ayumu-bekki/vhf-am-tx/README.md

# vhf-am-tx

Seeed Studio XIAO ESP32C6 を用いた 144MHz帯 終段ドレイン変調 AM(A1A / A2A / A3E)送信機プロジェクト。
ARDF(アマチュア無線方向探知)用のフォックスハンティング送信機(A2A)、手動キーのCW送信機(A1A)、および音声AM送信機(A3E)として動作します。

## 主な仕様

- **送信周波数**: 144.000 〜 146.000 MHz(20 kHz ステップ、Si5351A PLL制御)
- **電波型式**:
  - **A1A**: 搬送波断続の電信(CWモード専用)
  - **A2A**: トーン変調電信(700 Hz 正弦波、ARDF 5分サイクル・MOE/MOI/MOS/MOH/MO5・MO/S連続送信対応)
  - **A3E**: 振幅変調電話(マイク入力・デジタル音声信号処理 300 Hz〜3 kHz)
- **送信出力**: 搬送波 1.5 W / 変調ピーク 6.0 W(終段 LDMOS `HTL7G06S006P`)。1.5 W / 500 mW / 100 mW の3段から選択可能
- **変調方式**: 終段ドレイン変調(高レベル変調：250 kHz PWM + 2段RCフィルタ + `NJM2125F` / `2SK4017` シリーズパスレギュレータ)
- **電源電圧**: DC 12.8 V(4S LiFePO4 バッテリー、10.5〜17 V 対応、低電圧警告・送信禁止保護機能付き)
- **ユーザーインターフェース**: I2C キャラクタ LCD(`AQM1602Y` / ST7032)+ 3ボタン操作(Mode / Fn+ / Fn-)

## 動作モード

`Mode` ボタンで次の順に切り替わります(Fn+ = SW1、Fn- = SW2)。

| モード | 内容 |
|---|---|
| VOICE | A3E 音声。Fn+ を押している間だけ送信 |
| CW | A1A 手動キー。Fn+ を押している間だけ送信 |
| ARDF | A2A 自動送信。Fn+ で開始、**Fn+ の1秒長押しで停止** |
| FREQ | 周波数(20 kHz ステップ) |
| PWR | 出力切り替え(H:1.5 W / M:500mW / L:100mW) |
| CALL | コールサイン編集 |
| ID | ARDF 識別信号(MOE / MOI / MOS / MOH / MO5 / MO) |
| WPM | CW 速度(5〜40) |

- LCD 上段の右端に出力の段を `H`(1.5 W)/ `M`(500 mW)/ `L`(100 mW)で、VOICE・CW・ARDF モードのときだけ常時表示します(FAULT 表示中は出しません。PWR モードは上段が `H:1.5W` / `M:500mW` / `L:100mW`)。下段の右端はバッテリー電圧です。
- `idf.py menuconfig` の `AM Transmitter` メニューで **ARDF モード**と **CW モード**を個別に無効にできます。ARDF を無効にすると ARDF・ID・WPM の各モードが巡回から外れます(CALL は残ります)。デバッグ用のテストモード(`D:DUTY` / `D:CARR` / `D:TONE` / `D:DOT` / `D:BRST`)も同じメニューで有効にします。`D:DOT` は A1A の短点を連続送出し、`D:CARR` の S は PWR で選んだ段の搬送波を出します。

## ディレクトリ構成

```text
.
├── app/vhf-am-tx/    # ESP-IDF ファームウェア(ESP32-C6 / C++)
│   ├── main/         # アプリケーション本体ソースコード
│   └── test/         # ホストPC上で実行可能な単体テスト
├── pcb/vhf-am-tx/    # KiCad 基板設計データ(100×100mm 2層基板)およびガーバーデータ
└── doc/              # ハードウェア設計書(回路・定数・部品表・立ち上げ調整記録)
```

## ビルドとテスト

### ファームウェアのビルド・書き込み

本ファームウェアは **ESP-IDF**(ターゲット: `esp32c6`)を使用します。

```sh
cd app/vhf-am-tx
idf.py set-target esp32c6
idf.py build
idf.py flash monitor
```

> **Note**: 実機で USB ケーブルを接続して書き込みを行う際は、基板上のジャンパ `J12`(BP5293-33 3.3V出力 ↔ XIAO 3V3)を取り外し、電源の競合を避けてください。また、ベンチテスト時やデバッグモードを有効化する場合は `idf.py menuconfig` の `AM Transmitter` メニューから設定を変更できます。

### ホスト単体テストの実行

CWキーヤ(A1A の波形と CLK0 切り替えのタイミングを含む)・ARDFスケジューラ・出力の段のデューティ写像・送信シーケンス(ドレイン電圧ランプダウン後のキャリア遮断順序など)のロジックは、実機なしでホストPC上で高速にテストできます。

```sh
cd app/vhf-am-tx/test
./run_tests.sh
```

## ドキュメント

ハードウェアの詳細設計、回路定数の根拠、コイルの巻き方、部品表(BOM)、および立ち上げ・調整手順については以下を参照してください。

| 資料 | 内容 |
|---|---|
| [回路設計書](docs/01-circuit-design.md) | 回路と定数の根拠、電源、レベル配分、設計上の注意、付録A マイク入力 |
| [製作ガイド](docs/02-build-guide.md) | 部品表、基板 v0.1、2SK4017 の取り付けとケース、手巻きコイル |
| [調整手順書](docs/03-bring-up.md) | 切り離し点と測定点、測定器と測り方、立ち上げ手順 1〜9、試作で決まった値、実測記録 |
| [ホスト単体テスト](app/vhf-am-tx/test/README.md) | |

| 項目 | 値 |
|---|---|
| 周波数 | 144 MHz 帯（Si5351A） |
| 電波型式 | A1A / A2A / A3E |
| 最大出力 | 搬送波 1.5 W（ピーク 6 W）|
| 変調 | 終段ドレイン変調（NJM2125F ＋ 2SK4017 のシリーズパス） |
| 終段 / ドライバ | HTL7G06S006P（C級）/ 2SC4703（A級） |
| MCU | Seeed XIAO ESP32-C6 |
| 電源 | 4S LiFePO4（12.8 V） |

## ライセンス

本プロジェクトは [CERN Open Hardware Licence Version 2 - Permissive (CERN-OHL-P v2)](LICENSE) のもとで公開されています。
