ayumu-bekki/vhf-am-tx/docs/02-build-guide.md

# 144MHz 送信機 製作ガイド

v0.1 基板（1枚・100×100mm・2層）を**組み立てるとき**に開く資料。部品表、基板の要点、2SK4017 の取り付けとケース、手巻きコイルを扱う。回路の理由は [回路設計書](01-circuit-design.md)、立ち上げと調整は [調整手順書](03-bring-up.md)。

| 項目 | 値 | 補足 |
|---|---|---|
| Frequency | **144 MHz** | Si5351A / PLL |
| Emission | **A2A** | トーン変調電信 |
| Power | **1.5 W** | 搬送波 / ピーク 6 W |
| Modulation | **Drain** | 終段ドレイン変調 |
| Battery | **12.8 V** | 4S LiFePO4 / 約 0.7 A |

**目次**

- [01 部品表](#01-部品表)
- [02 基板（v0.1）](#02-基板v01)
- [03 2SK4017 の取り付けとケース](#03-2sk4017-の取り付けとケース)
- [04 手巻きコイルの製作](#04-手巻きコイルの製作)

## 01 部品表

回路図 `AmTransmitter.kicad_sch`の記号に対応させた一覧。全体を1枚の基板（100×100mm・2層）に載せる。基板に載らないのは BT1、SW1〜SW3、Q2（2SK4017）と、その足元に付ける R9・C5・J7。コイルの巻き方は 04章、判断の根拠は別資料の設計判断記録を参照。

コネクタとテストポイント：

- **電源** — J5 = バッテリー（XT30）、J4 = 主電源スイッチ SW_Power（XH 2ピン）、J8 = NJW4190M。
- **ジャンパ** — J11 = ドライバのコレクタ給電（+8V）、J12 = BP5293-33 → XIAO 3V3（USB 書き込み時は外す）、J13 = 終段のドレイン給電（Mod → L8）。
- **信号** — J1〜J3 = 押しボタン SW1〜SW3、J6 / J7 = 2SK4017 への引き出し（基板側 / FET 側）、J9 = マイク、J10 = LCD、**J14 = RF 出力**。
- **テストポイント** — TP2 = Mod（変調器出力）、TP3 = +8V、TP5 = ゲートバイアス、TP6 = BP5293-33 出力、TP9 = +3.3VB、TP1 / TP4 / TP7 / TP8 = GND（TP4 は R28、TP8 は R37、TP7 は R36 の隣）。

### バッテリーと保護

| 記号 | 定数 / 型番 | 備考 |
|---|---|---|
| BT1 | LiFePO4 4S 12.8V | 3〜6Ah。10.5〜17V が使用可能範囲 |
| F1 | ポリスイッチ 1.85A / 30V | 60°C で保持 1.2A。ピーク 1.05A に対して余裕あり |
| J5 | XT30（基板取付） | バッテリー入力。pin1 = GND、pin2 → F1 |
| J4（SW_Power） | XH 2ピン → 外付け SPST | 主電源。押しボタン（SW1〜SW3）と役割が違うので、スイッチ自体には番号を振らずコネクタ J4 で区別する |
| Q1 | SSM3J334R（Pch） | 逆接保護。D=電池側 / S=負荷側 / G=R6 経由で GND。V<sub>GSS</sub> ±20V（設計判断記録 ADR-015） |
| D1 | 6.8V ツェナー | Q1 の G-S間クランプ。電池電圧（10.5〜17V）が常時 Vgs にかかる構成のため、余裕を持たせる（ADR-015） |
| R6 | 100 kΩ | Q1 のゲート抵抗（G → GND）。D1 が導通したときの電流を約 0.1mA（17V 時）に抑える。省略してゲートを GND に直結しないこと（ADR-015） |
| C4 | 470 µF | 入力バルク。**耐圧 25V 以上**（電池が最大 17V） |
| R4 / R7 | 100 kΩ / 18 kΩ | バッテリー電圧監視の分圧（→ D0）。比 6.556 で 17V→2.59V、10.5V→1.60V。**逆接保護 Q1 の後ろ**から取る。常時 144µA |
| C7 | 0.1 µF | R7 と並列。**省略不可** — マイクと ADC を共用するため、分圧の高インピーダンスが隣の変換に漏れるのを防ぐ |

### 17.4V（変調器オペアンプ用）

| 記号 | 定数 / 型番 | 備考 |
|---|---|---|
| J8 | NJW4190M | 倍電圧チャージポンプ |
| C10 / C9 | 1 µF / 1 µF | 入力 / フライング |
| C18 / C19 | 1 µF / 10 µF | 出力 |
| R16 / R17 | 10 kΩ / 130 kΩ | FB→GND / FB→VOUT。`1.24 × (1+130/10) = 17.4V` |
| R11 / R14 | 33 kΩ / 10 kΩ | +BATT から J8（NJW4190M）の 7番ピンへの分圧（回路図どおり） |

### 8V（変調器パス・ドライバ・ゲートバイアス）

| 記号 | 定数 / 型番 | 備考 |
|---|---|---|
| U4 | RT8250GSP | 降圧 3A |
| C26 / C27 | 10 µF / 10 µF | 入力 |
| C36 | 0.1 µF | SS ピン（ソフトスタート）のバイパス |
| C28 | 0.01 µF | ブートストラップ |
| R24 | 100 kΩ | EN プルアップ |
| C38 / R30 | 4700 pF / 12 kΩ | 位相補償 |
| L5 | 15 µH | 2A 以上の飽和電流 |
| R25 / R27 | 39 kΩ / 5.1 kΩ | FB。`0.923 × (1+39/5.1) = 7.98V` |
| C31 | 22 µF | コンバータ直近。帰還ループはこれで決まる |
| FB1 | BLM18PG121SN1D | 120Ω@100MHz / 2A / 0.05Ω。ドライバと終段の RF がコンバータへ回り込むのを止める |
| C32 / C33 / C34 / C35 | 470 µF / 10 µF / 0.1 µF / 1000 pF | **ビーズの負荷側**。470µF が 700Hz の落ち込みを支える |

### 3.3V(A)（MCU）

| 記号 | 定数 / 型番 | 備考 |
|---|---|---|
| U5 | BP5293-33 | ROHM。3端子内蔵型 DC/DC。コイル・コンデンサ内蔵。7〜26V → 3.3V / 1A、SLLM制御 570kHz |
| C47 | 10 µF セラミック | 入力。データシート推奨値 |
| C49 | 22 µF セラミック | 出力。内蔵コンデンサのみでも動作するが、SLLM動作のリップル（50〜200mVpp）を抑えるため追加 |
| J12 / TP6 | 2ピン（ジャンパ）/ テストポイント | BP5293-33 出力 → XIAO 3V3（+3.3VA）。**USB 書き込み時は外し**、内蔵レギュレータとの競合を避ける（ADR-014）。TP6 は BP5293-33 側 |
| C48 | 100 µF | BLE 送信バーストの吸収 |

### 3.3V(B)（Si5351A 専用）

| 記号 | 定数 / 型番 | 備考 |
|---|---|---|
| R38 | 82 Ω | LDO の損失を 179mW → 65mW に。C62 と組んで fc 194Hz |
| C62 | 10 µF | LDO 入力 |
| U6 | NJM78L33SU3 | 3端子 3.3V |
| C63 | 0.1 µF | LDO 出力 |
| FB2 | BLM18PG121SN1D | **電源を綺麗にするためではなく、145MHz の閉じ込めのため**（[回路設計書 09章](01-circuit-design.md#09-電源系統)）。DCR 0.05Ω なので 38mA で 2mV しか落ちない |
| C64 / C65 | 10 µF / 0.1 µF | **モジュール直近に最短で** |

### MCU とトーン生成（M1 / M2）

| 記号 | 定数 / 型番 | 備考 |
|---|---|---|
| U1 | XIAO-ESP32-C6 | 3V3 ピンから給電。VBUS は未接続 |
| R2 / R3 | 10 kΩ × 2 | I2C プルアップ（SCL / SDA）。<strong>+3.3VA へ</strong>（Si5351A モジュールに内蔵なし。[回路設計書 09章](01-circuit-design.md#09-電源系統)） |
| R21 / C23 | 1 kΩ / 0.047 µF | 1段目 RC |
| R22 / C24 | 1 kΩ / 0.047 µF | 2段目 RC。合成 fc 3.39kHz |
| R23 | 100 kΩ | Tone PWM のプルダウン。Hi-Z の間に変調器の基準を 0V に落とす（[回路設計書 04章](01-circuit-design.md#04-m2-トーン生成と平滑フィルタ)） |
| SW1 / J1 | 押しボタン（D10、ネット SW 0） | モード切替。基板から除外 — 実装時は外部配線かパネル取付 |
| SW2 / J2 | 押しボタン（D9、ネット SW 1） | Function ＋（音声モードでは PTT）。基板から除外 |
| SW3 / J3 | 押しボタン（D8、ネット SW 2） | Function −。基板から除外 |

### 表示

| 記号 | 定数 / 型番 | 備考 |
|---|---|---|
| J10 | AQM0802A-RN-GBW（9ピンコネクタ接続） | ST7032 / 8×2 / I2C（0x3E）。VDD 3.1〜3.5V、消費 0.4mA、バックライトなし。**電源は +3.3VA** |
| C14 / C15 / C16 | 1 µF / 1 µF / 0.1 µF | 内蔵昇圧用とバイパス。データシート指定 |
| （RESET） | 10 kΩ プルアップ または GPIO | 開放にしない |
| （SDA / SCL 直列） | 100 〜 220 Ω | ケーブルで引き出す場合。エッジを鈍らせて RF の回り込みを抑える |

### マイク（回路設計書 付録A）

| 記号 | 定数 / 型番 | 備考 |
|---|---|---|
| J9 | AE-SPU0414（SPU0414HR5H-SB） | 1 = VDD、2 = OUT、4 = GND |
| R10 / C12 | 100 Ω / 10 µF | マイク電源のフィルタ（fc 約 160Hz）。C12 はモジュールの近く |
| C11 | 0.01 µF | 交流結合。バイアス 50kΩ と組んで fc 318Hz のハイパス |
| R12 / R15 | 100 kΩ × 2 | ADC バイアス 1.65V。**R12 の上側は R10 / C12 の接続点から**（+3.3VA 直結にしない） |
| R13 / C13 | 1 kΩ / 0.047 µF | アンチエイリアス（fc 3.4kHz）→ MicADC（D1） |

### 変調器（M3）

| 記号 | 定数 / 型番 | 備考 |
|---|---|---|
| R1 / C1 | 100 Ω / 10 µF | 17.4V の 300kHz リプル除去 |
| U2 | NJM2125F | 単電源・入力同相に GND を含む |
| R5 / R8 | 10 kΩ / 22 kΩ | FB→GND / FB→ソース。1/3.2 分圧（ゲイン 3.2）。20k から変更（ADR-024）— **ファームウェアの定数と対** |
| C6 | 1000 pF | オペアンプ出力 ↔ −入力。位相補償（ADR-026）。ピン直近 |
| C2 / C3 / C25 | 0.1µF＋1000pF / 1000pF | V+ と＋入力。RF の飛び込み対策。ピン直近 |
| R9 | 470 Ω | ゲート直列。**J7 側、ゲートの足に直付け** |
| Q2 | 2SK4017 | ソースフォロワ。TO-220SIS。**ケース側板に取付、外側にヒートシンク**（03章） |
| C5 | 0.1 µF | **J7 側、D–GND**。ドレインの足元のパスコン |
| J6 / J7 | 4ピンコネクタ ×2 | 基板側 / FET 側。1 = +8V・D、2 = オペアンプ出力・R9、3 = GND、4 = Mod・S。4本より合わせ 10cm 以内、電流線は AWG22〜20 |
| （ヒートシンク） | 8°C/W 以下 | ケース外側、2SK4017 の真裏。M3 共締め・グリス2面 |
| C8 | 0.1 µF | ソースフォロワ出力のバイパス。**基板側の Mod / TP2 ノード**。**出力クランプ用ツェナーは不要**（[回路設計書 03章](01-circuit-design.md#03-変調器m3の回路図)。バッテリー逆接保護の D1 とは別の話） |

### 搬送波生成とフィルタ

| 記号 | 定数 / 型番 | 備考 |
|---|---|---|
| U3 | AE-Si5351A-B | 1=VDDO / 2=SCL / 3=SDA / 4=GND / 5=CLK0 / 8=VDD。基準 25MHz |
| C17 | 1000 pF | 直流阻止。**パッドの前** |
| R19 / R18 / R20 | 300 Ω / 18 Ω / 300 Ω | 3dB π型パッド |
| L1 / L2 / L3 | 47 nH × 3 | 定数k LPF。チップ B82498F3470J000（04章） |
| C20 / C21 / C22 | 22 pF × 3 | 同上 |

### ドライバ段

| 記号 | 定数 / 型番 | 備考 |
|---|---|---|
| R28 / TP4 | 0 Ω / GND テストポイント | 段間の切り離し（Si5351A のフィルタ → ドライバ）。外してピグテールを当てる（調整手順書） |
| J11 | 2ピン（ジャンパ） | +8V → ドライバのコレクタ給電（R26・L4・C29 / C30）。外すとドライバだけ止められる |
| C40 | 1000 pF | 直流阻止 |
| C41 | 30 pF トリマ | 入力並列 C（設計値 22pF） |
| L7 | 56 nH | 自作・可変 |
| R29 | 10 Ω | ベース直列。発振時は 22Ω へ |
| R26 / R31 | 3 kΩ / 620 Ω | ベースバイアス。Rth 514Ω |
| Q3 | 2SC4703 | Vcbo 25V。8V で使う |
| R32 / C42 | 12 Ω / 2200 pF | エミッタ。素子直下に最短で。R32 は 22Ω から変更（ADR-025） |
| L4 | 2.2 µH **巻線型** | コレクタ RFC。B82498F1222J000（SRF 330MHz / 130mA / 1.6Ω）。直流 30〜40mA なので定格に余裕あり。**積層チップは不可**（[回路設計書 07章](01-circuit-design.md#07-終段の整合回路)） |
| C29 / C30 | 1000 pF / 0.1 µF | コレクタ給電のバイパス |
| C39 | <strong>実装しない（DNP）</strong> | コレクタ並列 C。浮遊 6.63pF ＋ Cob 1.5pF で必要量 8.5pF がほぼ埋まる（[回路設計書 06章](01-circuit-design.md#06-ドライバ段2sc4703)・ADR-020）。パッドは残す — 抵抗置換法で Cob の代役を仮付けする場所になる |
| L6 | 120 nH | 自作・可変 |
| C37 | 1000 pF | 直流阻止。**直流が乗っている側に置く** |

### 終段：ゲートバイアスと入力整合

| 記号 | 定数 / 型番 | 備考 |
|---|---|---|
| R33 / RV1 | 15 kΩ / 10 kΩ 半固定 | 0〜3.20V。多回転型。3端子結線 |
| C44 / C45 / C46 | 10 µF / 0.1 µF / 1000 pF | 700Hz 除去 / 中域 / RF 接地 |
| R34 | 220 kΩ | ブリーダ。ワイパ断線時に 0V へ |
| R35 / L9 | 100 Ω / 1 µH **巻線型** | B82498F1102J000。ゲートは直流を流さないので**定格電流は不問**（RF 1mA）。**積層チップは不可**（[回路設計書 07章](01-circuit-design.md#07-終段の整合回路)） |
| R37 / TP8 | 0 Ω / GND テストポイント | 段間の切り離し（ドライバ → 終段）。外してピグテールを当てる（調整手順書） |
| TP5 | テストポイント | ゲートバイアス（RV1 のワイパ側） |
| C60 | 15 pF | C61 と並列。C0G 50V。可動域の下駄を履かせるための固定分（ADR-019） |
| C61 | 30 pF トリマ | 入力並列 C。C60 と合わせて **約 20〜45pF**、設計値 33pF（ADR-019） |
| L14 | 33 nH | 自作・可変。**φ3mm に 4回**（ADR-018）。値はデータシート実測 Zs による（ADR-016） |
| C51 | 1000 pF | 直流阻止 |

### 終段：ドレインと出力整合

| 記号 | 定数 / 型番 | 備考 |
|---|---|---|
| Q4 | HTL7G06S006P | LDMOS。ソースのビアを最優先 |
| J13 | 2ピン（ジャンパ） | ドレイン給電（pin1 = Mod、pin2 → C43 → L8）。運用時は短絡。Idq はここに電流計を直列に入れて読む。調整中は 10A レンジの電流計を挟んでドレイン電流を読む（調整手順書） |
| TP3 | テストポイント | +8V。ゲートバイアス分圧（R33 / RV1、0.32mA）も +8V から直接取る |
| C43 | 0.01 µF | **L8 の変調器側**。ドレイン側に付けると出力が出ない |
| L8 | 0.47 µH 空芯（自作） | 145MHz で 471Ω。φ5mm に 14回 |
| L10 | 14 nH | 自作・可変。φ3mm に 2回 |
| C50 | 0.01 µF | 直流阻止 |
| C52 / C53 | **56 pF** / 30 pF トリマ | 出力並列 C。浮遊込みの合計で約 83pF に合わせる（[回路設計書 07章](01-circuit-design.md#07-終段の整合回路)・ADR-021）。当初の 47pF ではトリマが最大端に寄った |

### 出力 LPF とアンテナ

| 記号 | 定数 / 型番 | 備考 |
|---|---|---|
| R36 / TP7 | 0 Ω / GND テストポイント | LPF を単体で掃引するための切り離し（[調整手順書の手順 7](03-bring-up.md#手順-7--終段と-lpfj13-は開けたまま始める)）。**外したまま送信しない** |
| L11 / L13 | 71 nH × 2 | 7次チェビシェフ 0.1dB / fc 160MHz |
| L12 | 78 nH | 中央 |
| C54〜C59 | 22 pF × 6 | 両端 22pF、中間は 22pF×2 で 44pF。**C0G(NP0) 100V**。1608 / 3216 のどちらでも可（基板の footprint に合わせる） |
| J14 | RF 出力（RG-174 直付け） | フットプリント `Coax_RG174_SolderDirect`（1 = 芯線、2 = 網線、網線パッドにビア）。網線はピッグテールにせず広く付け、ケーブルは基板に固定する。調整中はダミーロードへ |

### 発注時に効く指定

値だけで選ぶと失敗する部品をまとめた。**ここに挙がっていない部品は、値と一般的な耐圧（RF 系は C0G 50V、電源系は電圧の2倍）で選んでよい**。

サイズは**メトリック表記**で統一してある — `1608` = 1.6×0.8mm（インチ 0603）、`2012` = 2.0×1.25mm（インチ 0805）、`3216` = 3.2×1.6mm（インチ 1206）。部品によっては型番やシリーズ名にインチ表記が入っている（TDK SIMID 0805-F など）ので、発注時は実寸で確認すること。

| 部品 | 指定 | 理由 |
|---|---|---|
| C54〜C59 | C0G(NP0) **100V** | LPF 中央のノードに 33Vp・0.9Arms がかかる。50V 品では余裕がない。サイズは 1608 / 3216 のどちらでも電気的に成立する |
| C52 / C53 | C0G **100V**（トリマも 100V 級） | ここは LPF 入口と同じ 50Ω 点なので、変調ピークで **24.5Vpk**。C52 には約 0.8Arms も流れる |
| C50 | C0G 50V / **3216**（2012 まで可） | かかる電圧は 1.3V 前後なので耐圧は不問。効くのは電流で、L10 と直列なので **基板上で最大の 1.31Arms** が流れる。ESR の発熱（`I²×ESR`）がパッケージの放熱能力を超えるので **1608 以下にしない**。なお C0G の 0.01µF は体積を食うので、実際には 2012 / 3216 しか選択肢がない |
| C42 | **1608** C0G 2200pF | 自己共振 138MHz を利用して 144MHz でほぼ 0Ω にしている。サイズが変わると共振点が動く |
| RF 系のコンデンサ全般 | **C0G(NP0) 必須** | X7R は損失と電圧係数で使えない（[回路設計書 08章](01-circuit-design.md#08-出力-lpf-の設計)） |
| C41 / C53 / C61 | VHF 用セラミックトリマ | Q が低いとそのまま損失になる。C53 は上記のとおり 100V 級。**トリマは 0pF から始まらない**ので、可動域は最小容量込みで見積もる（C39 はこれが原因で DNP になった） |
| L1〜L3 / L4 / L9 | **2012** の巻線（ワイヤワウンド）型 | 積層型は 145MHz では共振点のはるか上で、抵抗として振る舞う（[回路設計書 07章](01-circuit-design.md#07-終段の整合回路)） |
| L5（RT8250） | **飽和電流 2A 以上** | 8V レールのピークが 1.47A |
| C4 / C1 / C9 / C10 / C18 / C19 / C26 / C27 / C47 | 耐圧 **25V 以上** | 電池電圧（最大 17V）とチャージポンプ出力 17.4V が直接かかる |
| C26 / C27 / C47（セラミック） | DC バイアス特性に注意 | 25V 品に 17V を加えると実効容量が半分以下になることがある。35V 品か1サイズ大きいパッケージを選ぶ |
| C32（470µF） | **低 ESR** | 700Hz・0〜1.5A の負荷変動を支える。汎用電解だと変調ピークで 8V レールが落ちる（[回路設計書 09章](01-circuit-design.md#09-電源系統)） |
| C9 / C10 / C18（NJW4190M） | 低 ESR | チャージポンプのフライング／入出力。データシート指定 |
| F1 | 保持電流 1.85A 級 | 60°C では定格の 65〜70% しか流せない。1.0A / 1.35A 品は変調ピークで誤動作する |
| RV1 | 10kΩ <strong>多回転（25回転）</strong>半固定 | Vgs(th) を 0.1V 単位で追い込むため。3端子（ポテンショメータ）結線で使う |
| 検波プローブのダイオード | 1SS270A（DC 60V） | 逆電圧が 49V に達する。1SS106 / BAT43（ともに 30V）では足りない |

## 02 基板（v0.1）

電源・MCU・変調器・RF 部をすべて1枚に載せる。回路の理由は回路設計書、立ち上げは調整手順書。

### 基板（v0.1）

電源・MCU・変調器・RF 部をすべて <strong>1枚の基板（100×100mm・2層）</strong>に載せる。部品は裏面、表面はほぼ全面 GND ベタ。

- <strong>RF の配線は裏面のマイクロストリップ、基準面は表面の GND ベタ。</strong>表面に配線を通すときは RF の通り道の上を避け、両側に GND ビアを並べる。
- <strong>GND ビアを密に打つ。</strong>RF のシャント C・エミッタのバイパス・Q4 のタブの GND パッドは真横にビア、基板の縁と RF 部の周りは 5mm 間隔程度。RF のシャント C の GND パッドはベタ接続（サーマルリリーフにしない）。
- **インピーダンスの低いノード（50Ω 系・ゲート・ドレイン）は太く短く**（1mm 前後）。高いノード（ドライバのコレクタ、約 280Ω）は細いままでよい — 容量を増やさない。
- **段間は 0Ω（R28 / R37 / R36）で切り離せるようにし、隣に GND のテストポイント**（TP4 / TP8 / TP7）を置く。NanoVNA のピグテールはここに当てる（調整手順書）。
- <strong>変調器（U2・J6）は RF 出力 J14 から離す。</strong>オペアンプの入力は RF が入ると整流されて出力がずれる。ピン直近のパスコン（C2 / C3 / C25）と、Mod・+8V の基板側の 1000pF（C66 / C67）で守る。
- <strong>RF 出力 J14 は RG-174 の直付け。</strong>網線はピッグテールにせず、網線パッドに広く付ける。ケーブルは基板に固定する。

### 実装の注意

- <strong>SOT-89 の放熱。</strong>終段の損失は搬送波時で約 0.7W（試作で電源電流から換算。設計時の見込みは 1.5W）と、通常運用では小さい。それでも異常時に跳ね上がるので経路は省かない。SOT-89 は熱抵抗が高いので、タブ下にベタ銅箔＋サーマルビアは必須です（v0.1 基板はタブ下とその周りに格子状のビア）。ここを軽く見ると変調ピークで素子温度が限界を超えます。**目標は 10°C/W 以下** — 変調基準が 3.3V に張り付いて 8V 連続になっても損失 6.3W / 温度上昇 63°C で収まり、素子を失わずに済みます（[回路設計書 03章](01-circuit-design.md#03-変調器m3の回路図)）。
- <strong>8V ラインにフェライトビーズ + 0.1µF。</strong>降圧DC-DC のインダクタは RF 部から離します。

## 03 2SK4017 の取り付けとケース

変調器のパス素子 2SK4017 は基板に載せず、ケースの側板に取り付けてリード線で基板とつなぐ。

### 2SK4017 の引き出し

**ケースの側板に取り付けてリード線で基板とつなぐ**。基板側 **J6** と FET 側 **J7**（どちらも 4ピン）の間を、4本より合わせた線で結ぶ。

| ピン | 基板側 J6 | FET 側 J7 | 線 |
|---|---|---|---|
| 1 | +8V | D（C5 の片側） | AWG22〜20。最大 1.5A |
| 2 | オペアンプ出力 | R9 470Ω → G | 細線で可 |
| 3 | GND | C5 の GND 側 | 細線で可 |
| 4 | Mod（C8・R8・TP2） | S | AWG22〜20。最大 1.5A |

> [!WARNING]
> **ソースフォロワを配線で伸ばすときの約束**
>
> - <strong>R9（470Ω）はゲートの足に直付け。</strong>基板側に残して長い線でゲートへ行くと、線のインダクタンスとゲート容量で VHF の寄生発振を起こしやすい。
> - <strong>C5（0.1µF）を FET の足元で D–GND。</strong>GND はケースではなく J7 の pin3（4本目の線）に取る。アルマイトの側板は本体と導通していないことがある。
> - <strong>帰還（R8）と C8 は基板側の Mod ノード。</strong>線の抵抗による電圧降下（1.5A で数十 mV）もループが補正する。線のインダクタンスはループに入るが、高域は C6 でオペアンプ出力から帰還しているので影響は小さい。
> - <strong>4本をより合わせて 10cm 以内（できれば 5cm）。</strong>RF 基板とアンテナコネクタの近くを通さない。
> - 基板側 J6 の pin3 は R5 やオペアンプの GND ではなく **8V 電源側の GND** に寄せる。J6 は 8V レールの出力コンデンサの近くに置く。

### 2SK4017 の取り付け

損失は最大約 3W（3.5W で設計）、放熱器側に許される熱抵抗は 12°C/W 以下（[回路設計書 03章](01-circuit-design.md#03-変調器m3の回路図)「放熱の見積もり」）。

- <strong>取り付け。</strong>ケース側板（1mm）の内側に 2SK4017、**同じ位置の外側にヒートシンク**を当て、M3 ネジ1本で3枚を共締めする。グリスは2面とも。板厚方向の熱抵抗は 0.05°C/W 程度で無視でき、1mm 板で熱が横に広がらない問題はヒートシンクが受け持つ。**ヒートシンクはカタログ値 8°C/W 以下**（40×40mm・フィン高 20mm 前後が目安）、フィンは縦向き。放熱用両面テープは使わない。
- <strong>絶縁は不要。</strong>TO-220SIS（フルモールド）なのでネジもヒートシンクも GND 電位でよい。
- <strong>確認。</strong>連続 30分で、ヒートシンクの根元（素子の真裏）が **60°C 以下**なら合格（チャネルはおよそ +25°C 以内）。

### ケースと GND

- <strong>ケースはアルミにして GND につなぐ。</strong>シールド（アンテナから戻る RF を変調器・MCU に入れない、終段の高調波を外へ漏らさない）と、2SK4017 の放熱を兼ねる。
- <strong>主な接地点は RF 出力のパネルコネクタ。</strong>RG-174 の反対側をパネル取付の BNC / SMA につなぎ、そのフランジでケースに落とす。
- <strong>基板は四隅の取付穴（H1〜H4、GND）から金属スペーサでケースに落とす。</strong>高周波では短く多点でつなぐほうが効く。
- <strong>大電流の戻りはケースに流さない。</strong>ドレイン電流（最大 1.5A）と電源の戻りは配線と基板の GND で返す。ケースは同じ電位にそろえるだけ。
- <strong>アルマイトや塗装は絶縁体。</strong>接触部は削るか菊座金で食い込ませる。**フタと側板も本体と導通させる**（浮いたままだとシールドが大きく落ちる）。
- <strong>ケーブルは固定する。</strong>RG-174 と 2SK4017 への4本の線は、はんだ部分に力がかからないよう基板やケースに固定する。

## 04 手巻きコイルの製作

手巻きにする 8本はすべて空芯で自作する。**φ0.65mm ポリウレタン線（2UEW、外径 0.694mm）を φ5mm（L10 / L14 は φ3mm）の丸棒に巻く**前提で定数を出した。平均直径は `心棒径 + 0.65mm`。巻数と巻き長はホイーラーの式による。チップで代用するコイル（L1〜L3、L4、L9）はここには含めない。使い分けの判断は次項を参照。

| 記号 | 用途 | 心棒 | 目標 | 巻数 | 巻き長 | ピッチ | 密着巻き時 |
|---|---|---|---|---|---|---|---|
| L8 | 終段ドレイン給電 | φ5 mm | 0.47 µH | 14 T | 10.6 mm | 0.75 mm | 0.50 µH |
| L6 | ドライバ出力整合（可変） | φ5 mm | 120 nH | 6 T | 6.9 mm | 1.15 mm | 169 nH |
| L12 | 出力 LPF 中央 | φ5 mm | 78 nH | 4 T | 3.9 mm | 0.98 mm | 95 nH |
| L11 / L13 | 出力 LPF 両端 | φ5 mm | 71 nH | 4 T | 4.5 mm | 1.13 mm | 95 nH |
| L7 | ドライバ入力整合（可変） | φ5 mm | 56 nH | 4 T | 6.4 mm | 1.61 mm | 95 nH |
| L14 | 終段入力整合（可変） | **φ3 mm** | 33 nH | 4 T | 4.7 mm | 1.18 mm | 48 nH |
| L10 | 終段出力整合（可変） | **φ3 mm** | 14 nH | 2 T | 2.1 mm | 1.05 mm | 17 nH |

手巻きにするのは 8本で、必要な線材は総延長で約 87cm（リード分込み）。10m 巻きを1本買えば足りる。心棒は **L10 と L14 が φ3mm、残り6本は φ5mm**。丸棒はドリルの軸で代用できる。

可変コイルの目標値は出発点で、最後は実測で決まる。試作で追い込んだ結果は **L6 ≈ 116nH**（設計 120nH）、<strong>L10 ≈ 14.1nH（リード込み）</strong>（設計 14nH）。L10 は見た目がかなり広がった状態で合ったが、リードのインダクタンスが加わっているためで、値としては正しい。L7 / L14 は大信号で決めるので未確定（[調整手順書 04章](03-bring-up.md#04-試作で決まった値調整の出発点)）。

> [!WARNING]
> **小さい値のコイルは心棒を細くする**
>
> - 目標が小さいコイルを φ5mm で作ると、巻数が足りないぶんを**ピッチを広げて稼ぐ**ことになる。線径 0.694mm に対して隙間が線径以上に開くと「ほぼバネ」になり、手で触れただけで形が変わってインダクタンスが動く。
> - <strong>L10（14nH）</strong>は φ5mm だと 2回でピッチ 3.2mm（隙間が線径の 3.6倍）。**φ3mm で 2回・ピッチ 1.05mm** にすると隙間は線径の半分に収まる。
> - <strong>L14（33nH）</strong>も同じ問題で、φ5mm・3回だとピッチ 2.01mm（隙間が線径の 1.9倍、密着巻きの 2.9倍まで引き伸ばすことになる）。**φ3mm・4回・ピッチ 1.18mm** なら隙間は線径の 0.49倍で、引き伸ばし率も 1.7倍に収まる（ADR-018）。
> - 可変コイルは伸縮させて追い込む前提なので、**目標値が可動域の真ん中あたりに来る**のが望ましい。L14 は φ3mm・4回にすることで、目標域 29〜35nH が巻き長 4.35〜5.59mm という扱いやすい幅に対応する。

> [!WARNING]
> **L8 に 1µH は要らない**
>
> - チョークに求められるのは「145MHz でドレインの負荷 3.5Ω に対して十分高いこと」だけ。**0.47µH でも 471Ω = 134倍**あり、負荷への影響は 0.7% にとどまる。
> - 長いソレノイドでは `L = µ₀ N A / p` なので、**巻数は L に比例し、直径の2乗に反比例**する。1µH のままだと φ5mm で 27回・20mm になるが、0.47µH なら **14回・10.6mm** で済む。
> - 線長は 479mm → 248mm、DCR は 24.8mΩ → 12.9mΩ。自己共振も 331MHz → 482MHz と遠ざかる。
> - 心棒を φ10mm にして 1µH のまま 11回にする手もあるが、直径が増えるぶん磁界が広がって出力 LPF と結合しやすい。**φ5mm で統一するほうが実装が楽**。
> - C43（0.01µF）との直列共振は 73MHz。ここには何も存在しないので問題ない。

### チップと手巻きの使い分け

チップは **2012（インチ 0805）の巻線（ワイヤワウンド）型**に限る。積層型は不可（[回路設計書 07章](01-circuit-design.md#07-終段の整合回路)）。判断はコイルに流れる**電流**と、**実測で追い込む必要があるか**の2点で決まる。

| 記号 | 値 | 実装 | 電流（搬送波 / ピーク） | 理由 |
|---|---|---|---|---|
| L1 / L2 / L3 | 47 nH | チップ<br>B82498F3470J000 | 8 mA | SRF 650MHz / 500mA / 0.13Ω、セラミックコア。145MHz で 45Ω |
| L4 | 2.2 µH | チップ<br>B82498F1222J000 | 40 mA（直流） | SRF 330MHz / 130mA / 1.6Ω、フェライトコア。145MHz で 2.48kΩ、負荷 281Ω の 8.8倍 |
| L9 | 1 µH | チップ<br>B82498F1102J000 | 1 mA | SRF 440MHz / 240mA / 0.55Ω、フェライトコア。145MHz で 1.02kΩ |
| L8 | 0.47 µH | 手巻き | <strong>0.80 / 1.50 A（直流）</strong> | 変調電流がそのまま流れる。この電流と SRF 300MHz 以上を両立するチップ品が存在しない。空芯なら飽和も無い |
| L6 | 120 nH | 手巻き | 45 mA | 電流は小さいが、伸縮で追い込めるほうが早い |
| L7 | 56 nH | 手巻き | 8 mA | 2SC4703 の Zin が推定値。**可変が前提** |
| L14 | 33 nH | 手巻き | 224 mA | データシート実測の Zs から決めた値（ADR-016）。心棒は φ3mm・4T（ADR-018）。**可変が前提** |
| L10 | 14 nH | 手巻き | **0.66 / 1.31 A** | 3.5Ω 側の直列素子なので**基板上で最も電流が大きい**。2012 チップ（Q=50）だとピークで 0.44W を消費し、定格も超える。空芯なら 0.12W |
| L11 / L12 / L13 | 71 / 78 / 71 nH | 手巻き | 0.17 / 0.35 A | 挿入損失が `0.22dB（Q=180）→ 0.65dB（Q=60）` に増え、1.5W のうち 200mW を失う |

チップは 5個で、<strong>TDK SIMID 0805-F（B82498F）</strong>で全部そろう。シリーズ名の 0805 はインチ表記で、実寸は 2012（2.0 × 1.25mm）。型番4桁目が `1` ならフェライトコア、`3` ならセラミックコア（低い値ほどセラミック）。

出力 LPF をチップにする選択肢もあるが、代償は挿入損失 0.4dB で、**試作の実測では阻止域を決めていたのはコイル間の結合ではなかった**（[回路設計書 08章](01-circuit-design.md#08-出力-lpf-の設計)）。空芯のままでよい。**L10 は電流の点で空芯以外の選択肢がない**。

> [!WARNING]
> **チョークに磁気シールド品は要らない**
>
> - B82498F は非シールドのドラムコアだが、**L4 / L9 が扱う RF 電流は 1〜3mA しかない**ので、外へ漏らす磁束は問題にならない。
> - 逆に拾う側も心配ない。最も電流の大きい L10（ピーク 1.31A）が L9 に `k = 0.01` という密結合をしたとしても、ゲート節点に現れるのは 1.4mV で、ドライブ 2.7V に対して <strong>−66dB</strong>。終段の利得 12dB を足してもループ利得 −54dB で、発振には遠く及ばない。
> - シールド品は磁性体でモールドする構造なので、**SRF と Q が下がる**。チョークにとって一番大事なのが SRF なので、この用途では不利な取り引きになる。B82498F の SRF 440MHz は非シールドだから得られている。
> - シールドが意味を持ちうるのは**出力 LPF をチップ化する場合**だけ。チップにするならシールド品を選ぶ。

### 巻き方

1. <strong>必ず密着巻きしてから伸ばす。</strong>伸ばすとインダクタンスは減る一方なので、目標より大きい状態から近づける。表の「密着巻き時」が出発点。
2. <strong>心棒から抜くと直径が 0.2〜0.4mm 広がる。</strong>インダクタンスが数% 増えるので、抜いた状態で実測して巻き長を詰める。
3. <strong>両端に 10mm のリードを残す。</strong>被覆はライターで焼いてから磨くか、はんだ槽に浸ける。
4. <strong>固定コイル（L8、L11〜L13）は形を接着で固める。</strong>可変の4本（L6 / L7 / L10 / L14）は追い込みが終わってから固定する。

### 実装上の制約

- <strong>出力 LPF の L11 / L12 / L13 はパッドの並びどおりに実装する。</strong>L12 の footprint だけ 90° 回してあるのは隣と軸を直交させるための意図的なもので、見た目を揃えて同じ向きにしない。間隔は直径の2倍以上。なお試作ではコイルを基板に垂直に立てる実験もしたが 433MHz の減衰はほぼ変わらず、コイル間の結合は支配的な要因ではなかった（[回路設計書 08章](01-circuit-design.md#08-出力-lpf-の設計)・ADR-022）。
- <strong>L8 は LPF から離す。</strong>直径が一番大きいコイルなので、軸を LPF と直交させ、できれば基板の反対側へ寄せる。
- <strong>L8 の直流特性。</strong>DCR 12.9mΩ でピーク 1.5A でも 19mV しか落ちない。空芯なので飽和は原理的に存在しない。自己共振は約 482MHz で 145MHz から十分離れており、実効インピーダンスは 471Ω。負荷 3.5Ω に対して 134倍あり、影響は 0.7%。
- <strong>測定は VHF で。</strong>LC メーターは 100kHz 前後で測るので VHF での実効値とずれる。NanoVNA があれば既知のコンデンサと直列共振させて求めるのが確実。

---

*JL1HMT / 144MHz A2A 送信機 — 製作ガイド（2 / 3）。回路設計書・調整手順書と組で使う。*
