ayumu-bekki/vhf-am-tx/pcb/vhf-am-tx/vhf-am-tx.kicad_pcb

## KiCad design pcb/vhf-am-tx/vhf-am-tx.kicad_pcb (2026-10-17)

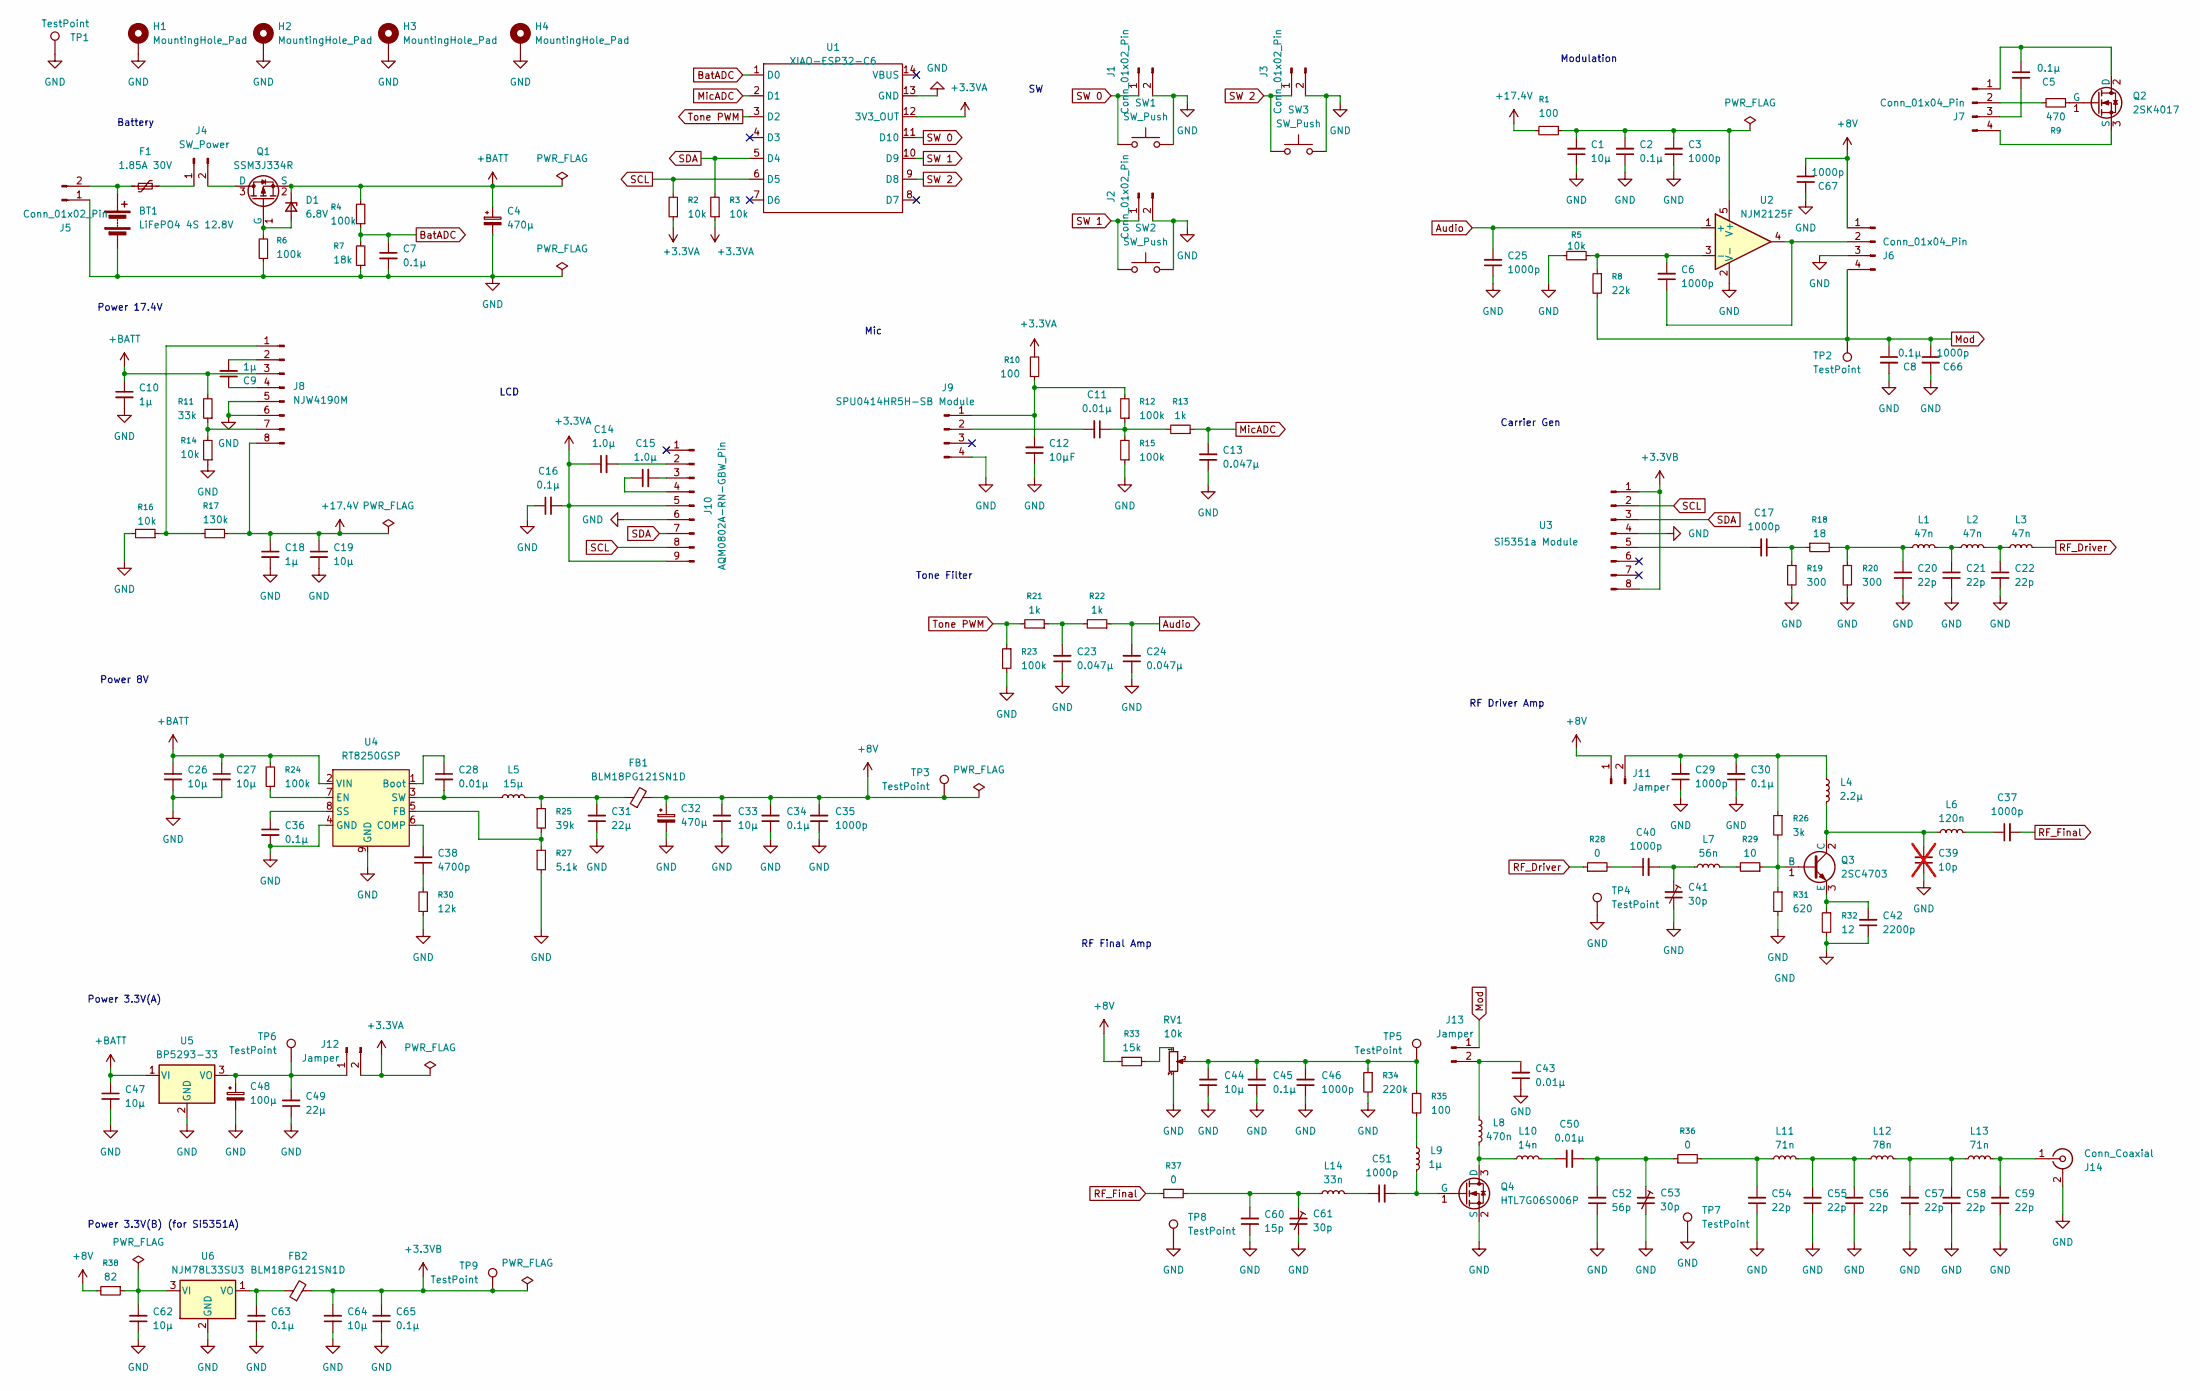
[picture p1: schematic vhf-am-tx.kicad_sch]

Parts:
BT1: LiFePO4 4S 12.8V
C1, C19, C26, C27, C33, C44, C47, C62, C64: 10μ; C_0603_1608Metric_Pad1.08x0.95mm_HandSolder
C2, C5, C7, C8, C16, C30, C34, C36, C45, C63, C65: 0.1μ; C_0603_1608Metric_Pad1.08x0.95mm_HandSolder
C3, C6, C17, C25, C29, C35, C37, C40, C46, C51, C66, C67: 1000p; C_0603_1608Metric_Pad1.08x0.95mm_HandSolder
C4, C32: 470μ; CP_Elec_8x10.5
C9, C10, C18: 1μ; C_0603_1608Metric_Pad1.08x0.95mm_HandSolder
C11, C28, C43: 0.01μ; C_0603_1608Metric_Pad1.08x0.95mm_HandSolder
C12: 10μF; C_0603_1608Metric_Pad1.08x0.95mm_HandSolder
C13, C23, C24: 0.047μ; C_0603_1608Metric_Pad1.08x0.95mm_HandSolder
C14, C15: 1.0μ; C_0603_1608Metric_Pad1.08x0.95mm_HandSolder
C20, C21, C22, C54, C55, C56, C57, C58, C59: 22p; C_0603_1608Metric_Pad1.08x0.95mm_HandSolder
C31, C49: 22μ; C_0603_1608Metric_Pad1.08x0.95mm_HandSolder
C38: 4700p; C_0603_1608Metric_Pad1.08x0.95mm_HandSolder
C39: 10p; C_0603_1608Metric_Pad1.08x0.95mm_HandSolder; not fitted
C41, C53, C61: 30p; C_Trimmer_Murata_TZC3
C42: 2200p; C_0603_1608Metric_Pad1.08x0.95mm_HandSolder
C48: 100μ; CP_Elec_6.3x5.8
C50: 0.01μ; C_1206_3216Metric_Pad1.33x1.80mm_HandSolder
C52: 56p; C_0603_1608Metric_Pad1.08x0.95mm_HandSolder
C60: 15p; C_0603_1608Metric_Pad1.08x0.95mm_HandSolder
D1: 6.8V; D_SOD-323_HandSoldering
F1: 1.85A 30V; Fuse_Bourns_MF-RHT650
FB1, FB2: BLM18PG121SN1D; L_0805_2012Metric_Pad1.05x1.20mm_HandSolder
H1, H2, H3, H4: MountingHole_Pad; MountingHole_3.2mm_M3_Pad
J1, J2, J3: Conn_01x02_Pin; JST_PH_B2B-PH-K_1x02_P2.00mm_Vertical
J4: SW_Power; JST_XH_B2B-XH-A_1x02_P2.50mm_Vertical
J5: Conn_01x02_Pin; AMASS_XT30PW-M_1x02_P2.50mm_Horizontal
J6: Conn_01x04_Pin; PinHeader_1x04_P2.54mm_Vertical
J7: Conn_01x04_Pin
J8: NJW4190M; SOIC-8_5.3x5.3mm_P1.27mm
J9: SPU0414HR5H-SB Module; PinHeader_1x04_P2.54mm_Vertical
J10: AQM0802A-RN-GBW_Pin; PinSocket_1x09_P2.54mm_Vertical
J11, J12, J13: Jamper; PinHeader_1x02_P2.54mm_Vertical
J14: Conn_Coaxial; Coax_RG174_SolderDirect
L1, L2, L3: 47n; L_0805_2012Metric_Pad1.05x1.20mm_HandSolder
L4: 2.2μ; L_0805_2012Metric_Pad1.05x1.20mm_HandSolder
L5: 15μ; L_10.4x10.4_H4.8
L6: 120n; Inductor_HandWound_SMD_Core5.0mm_W10.0mm
L7: 56n; Inductor_HandWound_SMD_Core5.0mm_W10.0mm
L8: 470n; Inductor_HandWound_SMD_Core5.0mm_W10.5mm
L9: 1μ; L_0805_2012Metric_Pad1.05x1.20mm_HandSolder
L10: 14n; Inductor_HandWound_SMD_Core3.0mm_W4.0mm
L11, L13: 71n; Inductor_HandWound_SMD_Core5.0mm_W5.0mm
L12: 78n; Inductor_HandWound_SMD_Core5.0mm_W5.0mm
L14: 33n; Inductor_HandWound_SMD_Core3.0mm_W5.0mm
Q1: SSM3J334R; SOT-23_Handsoldering
Q2: 2SK4017; TO-251-3_Vertical
Q3: 2SC4703; SOT-89-3_Handsoldering
Q4: HTL7G06S006P; SOT-89-3_Handsoldering
R1, R10, R35: 100; R_0603_1608Metric_Pad0.98x0.95mm_HandSolder
R2, R3, R5, R14, R16: 10k; R_0603_1608Metric_Pad0.98x0.95mm_HandSolder
R4, R6, R12, R15, R23, R24: 100k; R_0603_1608Metric_Pad0.98x0.95mm_HandSolder
R7: 18k; R_0603_1608Metric_Pad0.98x0.95mm_HandSolder
R8: 22k; R_0603_1608Metric_Pad0.98x0.95mm_HandSolder
R9: 470; R_0603_1608Metric_Pad0.98x0.95mm_HandSolder
R11: 33k; R_0603_1608Metric_Pad0.98x0.95mm_HandSolder
R13, R21, R22: 1k; R_0603_1608Metric_Pad0.98x0.95mm_HandSolder
R17: 130k; R_0603_1608Metric_Pad0.98x0.95mm_HandSolder
R18: 18; R_0603_1608Metric_Pad0.98x0.95mm_HandSolder
R19, R20: 300; R_0603_1608Metric_Pad0.98x0.95mm_HandSolder
R25: 39k; R_0603_1608Metric_Pad0.98x0.95mm_HandSolder
R26: 3k; R_0603_1608Metric_Pad0.98x0.95mm_HandSolder
R27: 5.1k; R_0603_1608Metric_Pad0.98x0.95mm_HandSolder
R28, R36, R37: 0; R_2512_6332Metric_Pad1.40x3.35mm_HandSolder
R29: 10; R_0603_1608Metric_Pad0.98x0.95mm_HandSolder
R30: 12k; R_0603_1608Metric_Pad0.98x0.95mm_HandSolder
R31: 620; R_0603_1608Metric_Pad0.98x0.95mm_HandSolder
R32: 12; R_0603_1608Metric_Pad0.98x0.95mm_HandSolder
R33: 15k; R_0603_1608Metric_Pad0.98x0.95mm_HandSolder
R34: 220k; R_0603_1608Metric_Pad0.98x0.95mm_HandSolder
R38: 82; R_0603_1608Metric_Pad0.98x0.95mm_HandSolder
RV1: 10k; TSR-3296W
SW1, SW2, SW3: SW_Push
TP1: TestPoint; TestPoint_THTPad_D2.0mm_Drill1.0mm
TP2, TP3, TP4, TP5, TP6, TP7, TP8, TP9: TestPoint; TestPoint_Pad_2.0x2.0mm
U1: XIAO-ESP32-C6; XIAO-ESP32-C6-DIP
U2: NJM2125F; SOT-23-5
U3: Si5351a Module; DIP-8_W7.62mm
U4: RT8250GSP; HSOP-8-1EP_3.9x4.9mm_P1.27mm_EP2.41x3.1mm
U5: BP5293-33; BP5293-XX
U6: NJM78L33SU3; SOT-89-3_Handsoldering

Connections:
+3.3VA: C14.1, C16.2, J10.5, J10.9, J12.2, R2.1, R3.1, R10.2, U1.12 (3V3_OUT)
+3.3VB: C64.2, C65.2, FB2.2, TP9.1 (1_1), U3.1, U3.8
+8V: C32.1, C33.2, C34.2, C35.2, C67.1, FB1.2, J6.1, J11.1, R33.1, R38.2, TP3.1 (1_1)
+17.4V: C18.1, C19.1, J8.8, R1.2, R17.1
+BATT: C4.1, C10.1, C26.1, C27.1, C47.1, D1.1 (K), J8.3, Q1.2 (S), R4.2, R11.2, R24.2, U4.2 (VIN), U5.1 (VI)
Audio: C24.2, C25.2, R22.1, U2.1 (+)
BatADC: C7.1, R4.1, R7.2, U1.1 (D0)
GND: BT1.2 (-), C1.1, C2.1, C3.1, C4.2, C7.2, C8.2, C10.2, C12.1, C13.1, C16.1, C18.2, C19.2, C20.2, C21.2, C22.2, C23.1, C24.1, C25.1, C26.2, C27.2, C29.1, C30.1, C31.1, C32.2, C33.1, C34.1, C35.1, C36.2, C39.1, C41.2, C42.1, C43.1, C44.1, C45.1, C46.1, C47.2, C48.2, C49.1, C52.1, C53.2, C54.1, C55.1, C56.1, C57.1, C58.1, C59.1, C60.1, C61.2, C62.1, C63.1, C64.1, C65.1, C66.2, C67.2, H1.1 (1_1), H2.1 (1_1), H3.1 (1_1), H4.1 (1_1), J1.2, J2.2, J3.2, J5.1, J6.3, J8.5, J8.6, J9.4, J10.6, J14.2 (Ext), Q4.2 (S), R5.2, R6.1, R7.1, R14.1, R15.1, R16.2, R19.2, R20.2, R23.2, R27.2, R30.1, R31.2, R32.2, R34.2, RV1.3, SW1.2, SW2.2, SW3.2, TP1.1 (1_1), TP4.1 (1_1), TP7.1 (1_1), TP8.1 (1_1), U1.13 (GND), U2.2 (V-), U3.4, U4.4 (GND), U4.9 (GND), U5.2 (GND), U6.2 (GND)
MicADC: C13.2, R13.1, U1.2 (D1)
Mod: C8.1, C66.1, J6.4, J13.1, R8.2, TP2.1 (1_1)
unnamed: C5.1, J7.1, Q2.2 (D)
unnamed: C5.2, J7.3
unnamed: C11.1, R12.1, R13.2, R15.2
unnamed: C17.1, R18.1, R19.1
unnamed: C20.1, L1.1, R18.2, R20.1
unnamed: C21.1, L1.2, L2.1
unnamed: C22.1, L2.2, L3.1
unnamed: C23.2, R21.1, R22.2
unnamed: C31.2, FB1.1, L5.2, R25.1
unnamed: C37.1, L6.2
unnamed: C38.1, R30.2
unnamed: C40.1, R28.2
unnamed: C40.2, C41.1, L7.1
unnamed: C44.2, C45.2, C46.2, R34.1, R35.1, RV1.2, TP5.1 (1_1)
unnamed: C50.1, L10.2
unnamed: C50.2, C52.2, C53.1, R36.1
unnamed: C51.1, L14.2
unnamed: C54.2, L11.1, R36.2
unnamed: C55.2, C56.2, L11.2, L12.1
unnamed: C57.2, C58.2, L12.2, L13.1
unnamed: C60.2, C61.1, L14.1, R37.2
unnamed: D1.2 (A), Q1.1 (G), R6.2
unnamed: F1.2, J4.1
unnamed: J4.2, Q1.3 (D)
unnamed: BT1.1 (+), F1.1, J5.2
unnamed: C6.1, J6.2, U2.4
unnamed: J7.2, R9.2
unnamed: J7.4, Q2.3 (S)
unnamed: J8.1, R16.1, R17.2
unnamed: C9.2, J8.2
unnamed: C9.1, J8.4
unnamed: J8.7, R11.1, R14.2
unnamed: C12.2, J9.1, R10.1, R12.2
unnamed: C11.2, J9.2
unnamed: C14.2, J10.2
unnamed: C15.2, J10.3
unnamed: C15.1, J10.4
unnamed: C29.2, C30.2, J11.2, L4.2, R26.1
unnamed: C48.1, C49.2, J12.1, TP6.1 (1_1), U5.3 (VO)
unnamed: C43.2, J13.2, L8.2
unnamed: C59.2, J14.1 (In), L13.2
unnamed: L7.2, R29.2
unnamed: L9.2, R35.2
unnamed: Q2.1 (G), R9.1
unnamed: Q3.1 (B), R26.2, R29.1, R31.1
unnamed: C39.2, L4.1, L6.1, Q3.2 (C)
unnamed: C42.2, Q3.3 (E), R32.1
unnamed: L8.1, L10.1, Q4.3 (D)
unnamed: C51.2, L9.1, Q4.1 (G)
unnamed: R33.2, RV1.1
unnamed: C6.2, R5.1, R8.1, U2.3 (-)
unnamed: C1.2, C2.2, C3.2, R1.1, U2.5 (V+)
unnamed: C17.2, U3.5
unnamed: C28.1, U4.1 (Boot)
unnamed: C38.2, U4.6 (COMP)
unnamed: R24.1, U4.7 (EN)
unnamed: R25.2, R27.1, U4.5 (FB)
unnamed: C36.1, U4.8 (SS)
unnamed: C28.2, L5.1, U4.3 (SW)
unnamed: C62.2, R38.1, U6.3 (VI)
unnamed: C63.2, FB2.1, U6.1 (VO)
RF_Driver: L3.2, R28.1
RF_Final: C37.2, R37.1
SCL: J10.8, R2.2, U1.6 (D5), U3.2
SDA: J10.7, R3.2, U1.5 (D4), U3.3
SW 0: J1.1, SW1.1, U1.11 (D10)
SW 1: J2.1, SW2.1, U1.10 (D9)
SW 2: J3.1, SW3.1, U1.9 (D8)
Tone PWM: R21.2, R23.1, U1.3 (D2)

Notes on the sheet:
Battery
RF Driver Amp
Carrier Gen
Modulation
LCD
Power 17.4V
Mic
Power 3.3V(B) (for Si5351A)
Power 8V
RF Final Amp
Power 3.3V(A)
Tone Filter

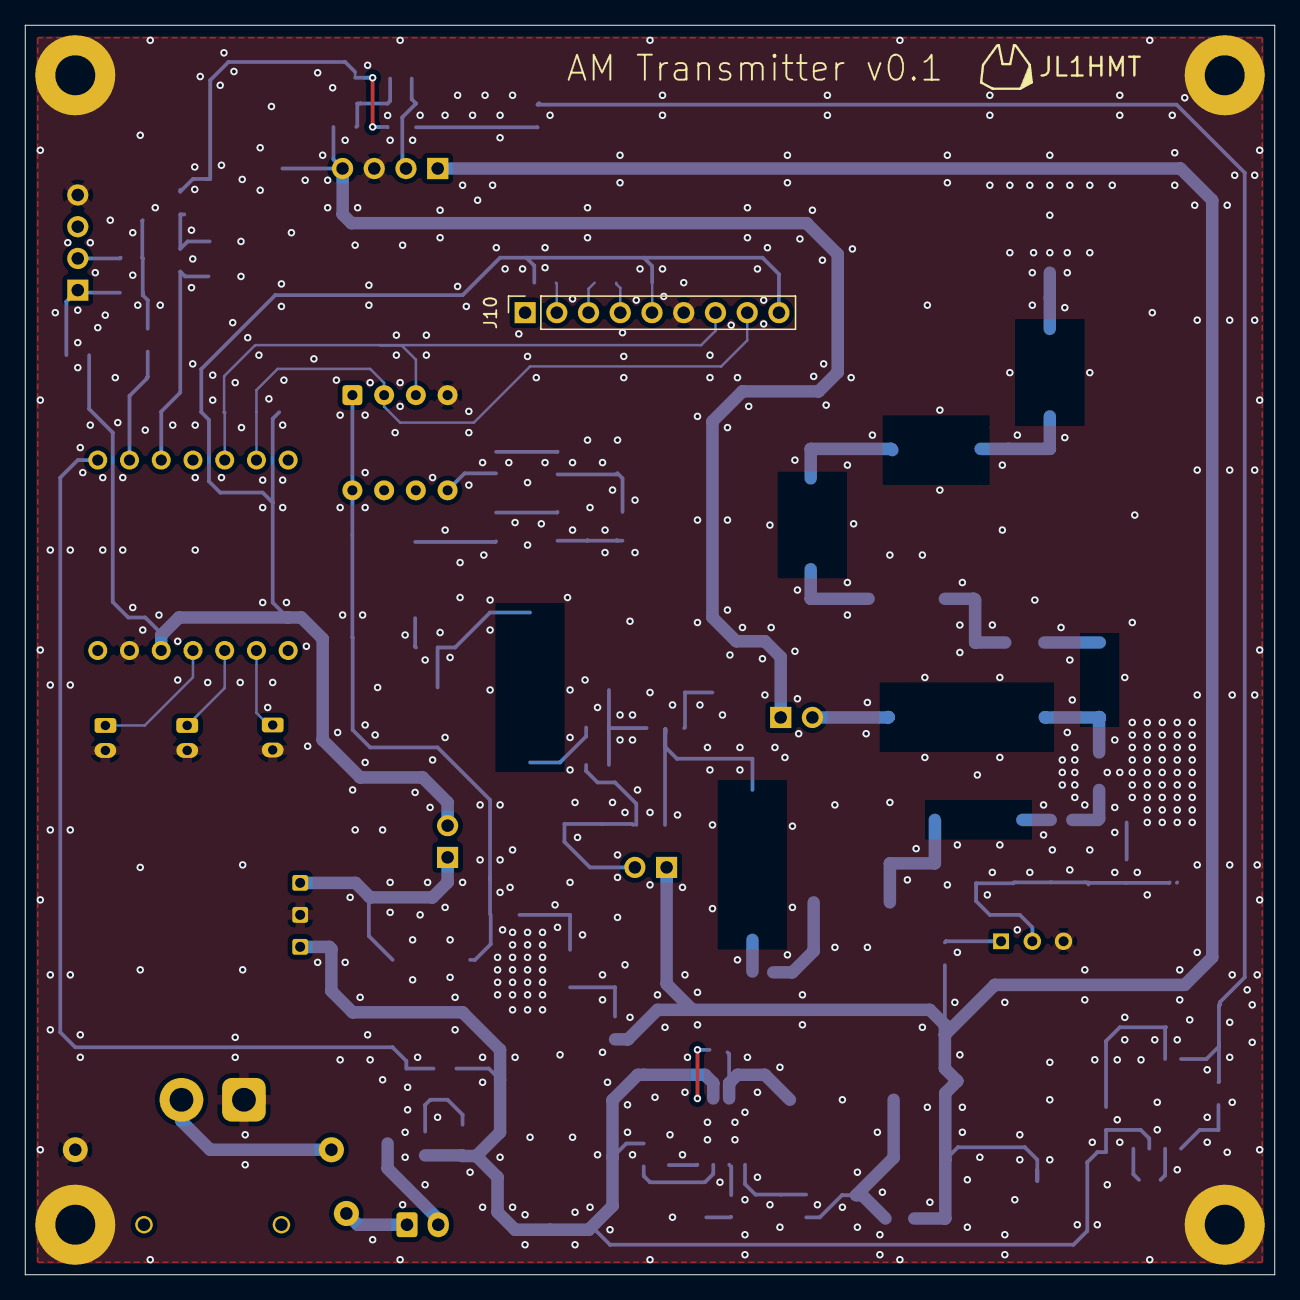
[picture p2: board vhf-am-tx.kicad_pcb from above]

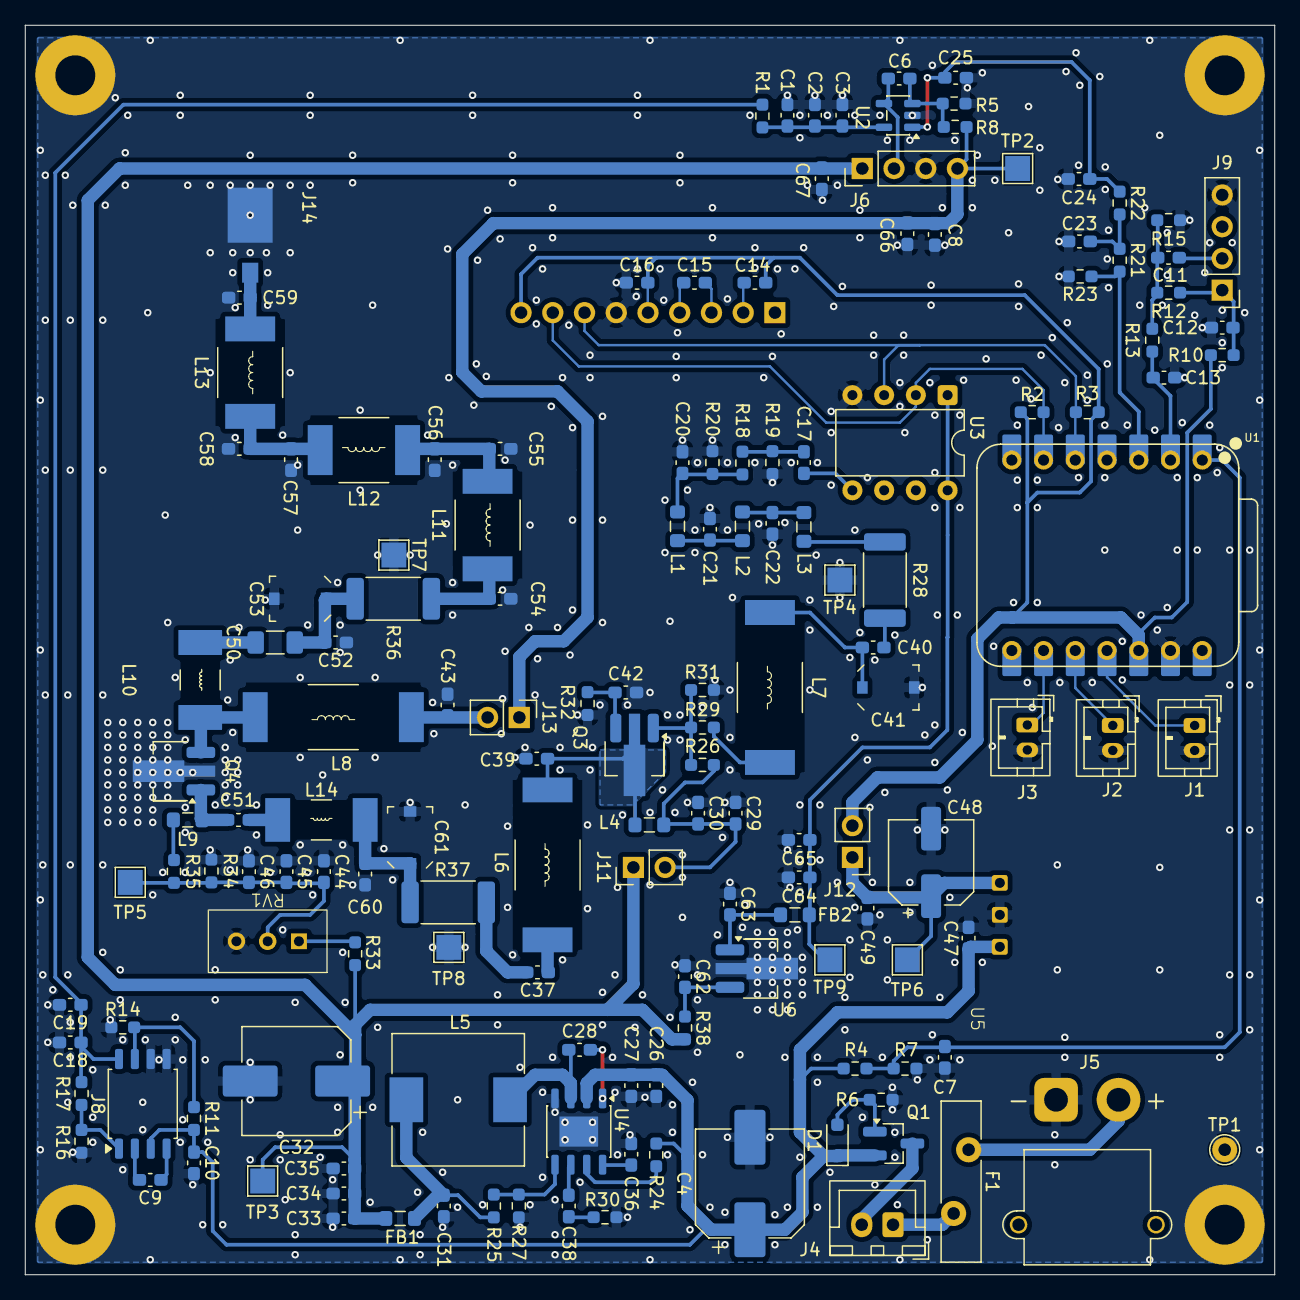
[picture p3: board vhf-am-tx.kicad_pcb from below]

Board: 2 copper layers, 100.0 x 100.0 mm, 157 parts (152 on the bottom side), 74 nets.
