ayumu-bekki/vhf-am-tx/(commit log)

2026-10-17 並行処理・安全性の不具合を修正 LCDコマンドI2C一括書き込み 送信中LED点灯 コールサイン既定値廃止
2026-10-17 READMEとライセンス文の追加
2026-10-18 不要コード整理
2026-10-18 ドキュメント更新
2026-10-19 出力変更(1.5W/500mW/100mW)とCWモード(A1A/A2A切替)を追加
2026-10-19 ARDFモードの停止をボタン長押しにした
2026-10-19 空中線出力表示対応
2026-10-19 CWモードでA2Aをサポートする意味がないのでA1A専用に変更
